oyvinmt/Automating-microscope-stages/README.md

# Automating-microscope-stages

Project for automatic Thorlabs microscope stages.

Contains stl files for 3d-prints, Arduino software, Python script and instructions for assembly and operation.
