oyvinmt/Automating-microscope-stages/Models/z_main_gear.stl

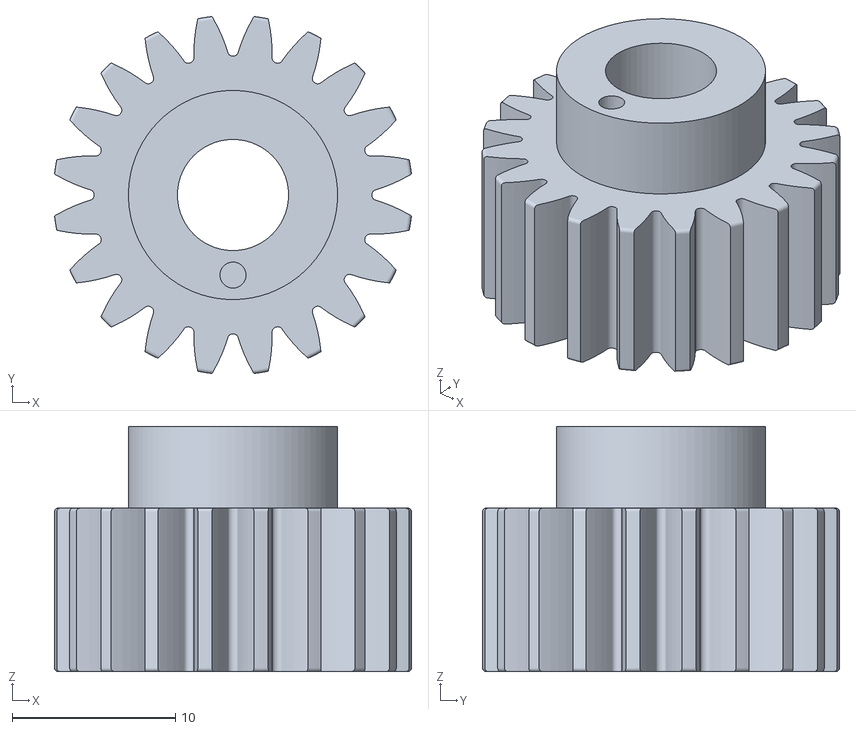
[picture p1: CAD file, 2021-06-25]
Models/z_main_gear.stl
21.8 x 21.8 x 15.0
