oyvinmt/Automating-microscope-stages/Models/z_second_gear.stl

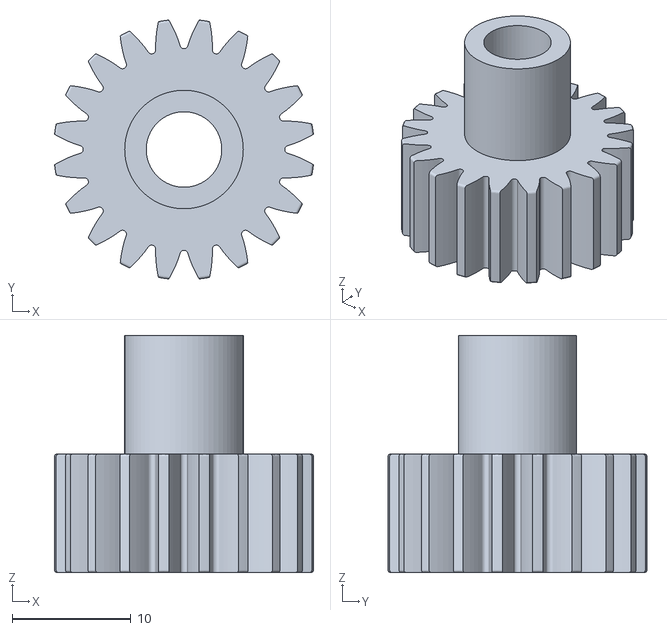
[picture p2: CAD file, 2021-06-25]
Models/z_second_gear.stl
21.8 x 21.8 x 20.0
