oyvinmt/Automating-microscope-stages/Models/Enclosure_body.stl

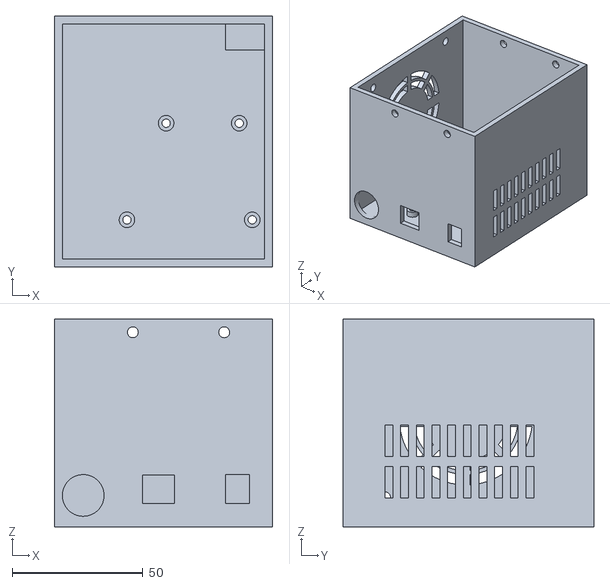
[picture p3: CAD file, 2021-06-25]
Models/Enclosure_body.stl
83.5 x 96.0 x 79.5
