oyvinmt/Automating-microscope-stages/Models/y_bracket.stl

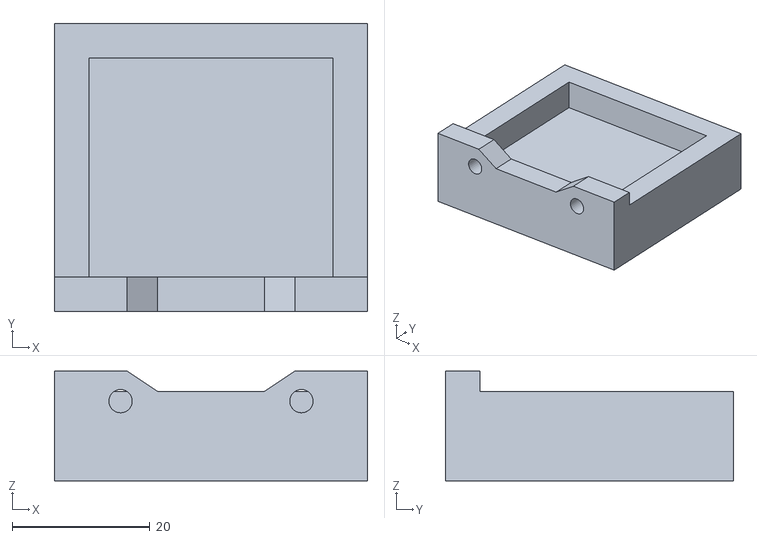
[picture p4: CAD file, 2021-06-25]
Models/y_bracket.stl
45.5 x 41.9 x 16.0
