oyvinmt/Automating-microscope-stages/Models/z_bracket.stl

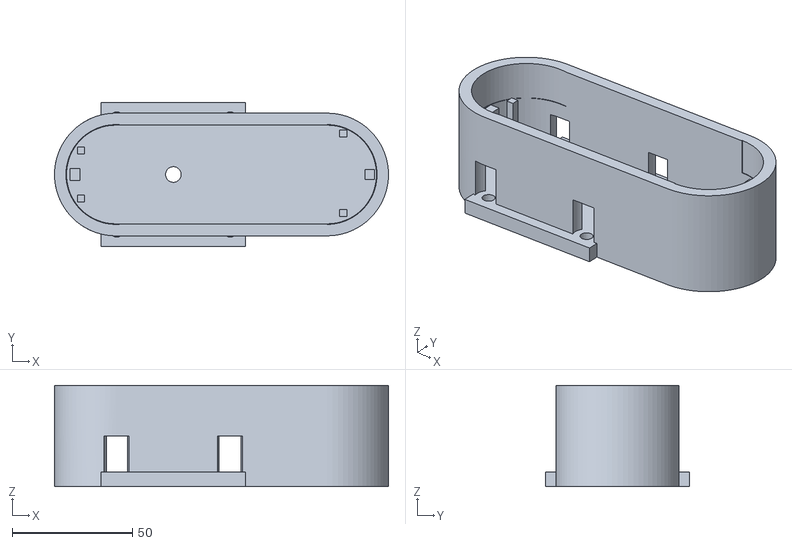
[picture p5: CAD file, 2021-06-25]
Models/z_bracket.stl
138.8 x 60.0 x 42.0
