oyvinmt/Automating-microscope-stages/Models/x_gear_1.stl

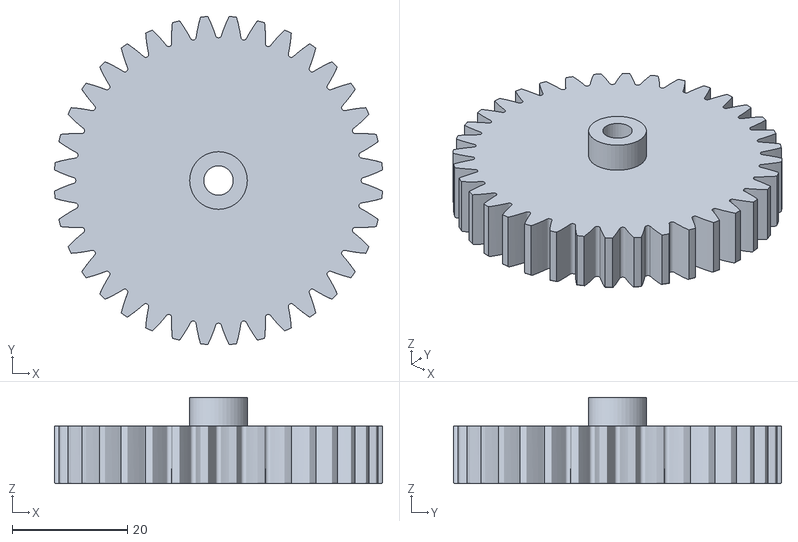
[picture p6: CAD file, 2021-06-25]
Models/x_gear_1.stl
56.9 x 56.9 x 15.0
