oyvinmt/Automating-microscope-stages/Models/y_coupling.stl

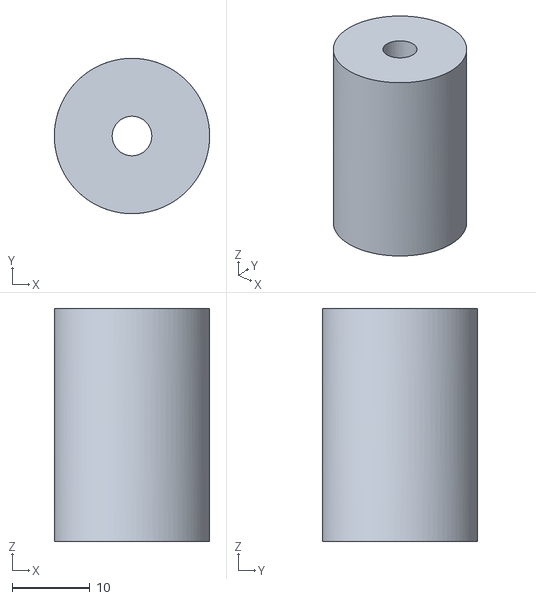
[picture p7: CAD file, 2021-06-25]
Models/y_coupling.stl
20.0 x 20.0 x 30.0
