oyvinmt/Automating-microscope-stages/Models/y_rail.stl

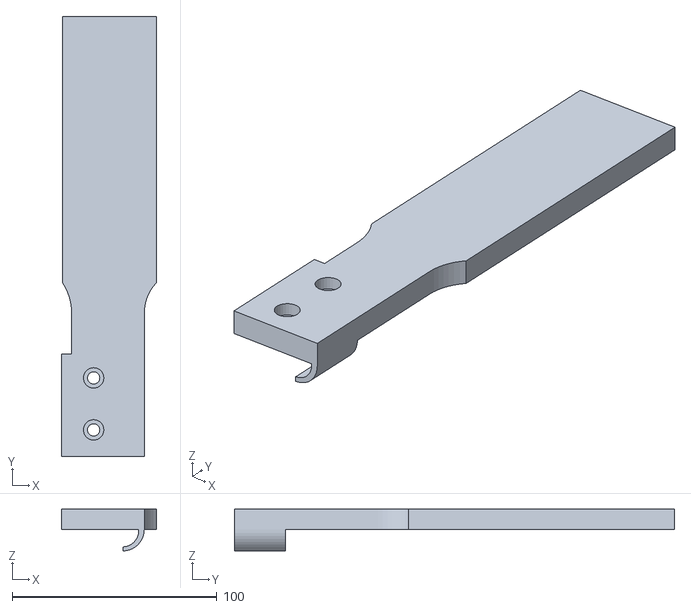
[picture p8: CAD file, 2021-06-25]
Models/y_rail.stl
46.5 x 215.0 x 20.5
