oyvinmt/Automating-microscope-stages/Models/x_gear_2.stl

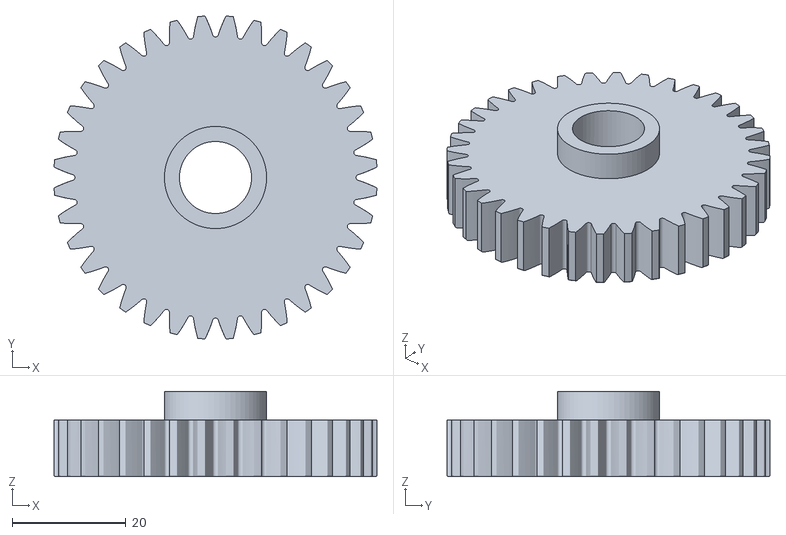
[picture p9: CAD file, 2021-06-25]
Models/x_gear_2.stl
56.9 x 56.9 x 15.0
