oyvinmt/Automating-microscope-stages/Models/x_motor_mount.stl

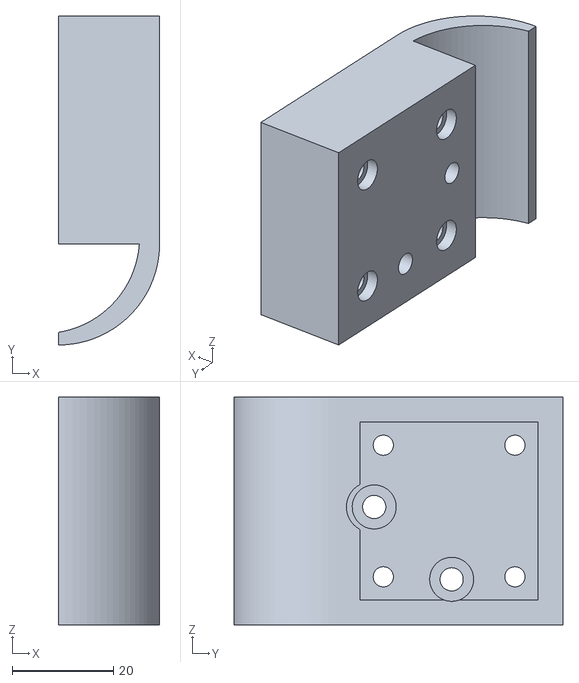
[picture p10: CAD file, 2021-06-25]
Models/x_motor_mount.stl
20.0 x 65.0 x 45.0
