oyvinmt/Automating-microscope-stages/Models/Enclosure_Lid.stl

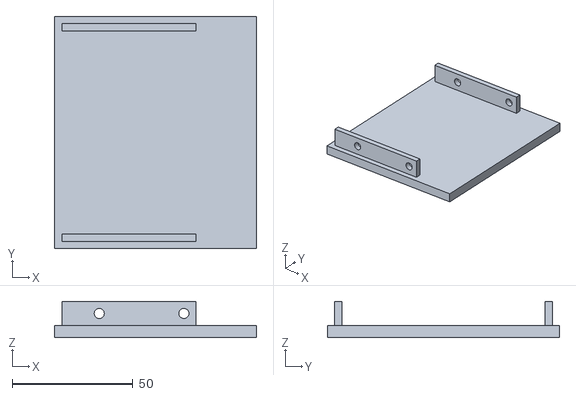
[picture p11: CAD file, 2021-06-25]
Models/Enclosure_Lid.stl
83.5 x 96.0 x 15.0
