oyvinmt/Automating-microscope-stages/Manual.pdf

# Operation manual

Øyvind M. Taraldsen

June 2021

## 1 Warnings

Do not power on the device without the motors attached as shown in figure 1. The Arduino can be powered on without issues, the dedicated motor supply can not.

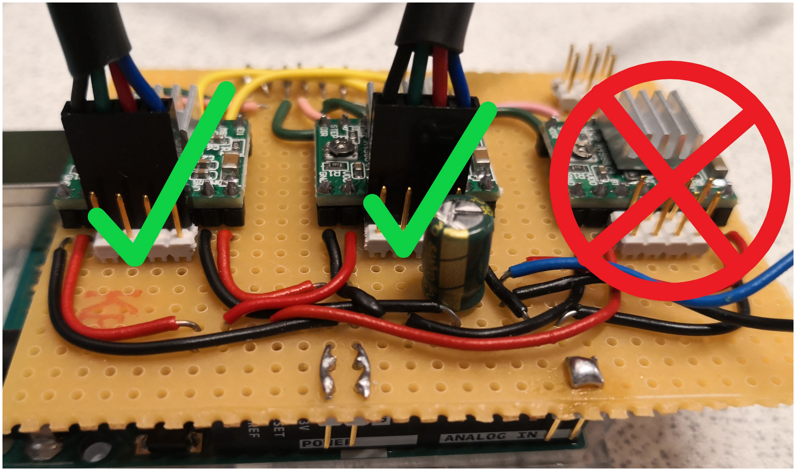
[picture p12: figure]

Figure 1: Never power on the device with nothing connected to the controller outputs. Doing so will burn out the controllers instantly.

## 2 Basic operation

Plug in the Arduino, the separate power supply for the motors and start the Python-script. The script should automatically detect the Arduino and connect to it 1
. You should see ”Arduino is ready” and a pygame window appearing when it is working correctly.

1Note that any programs running that connect through a serial interface to an Arduino (like the Arduino IDE) may autoconnect and block the script from doing so.

Operation is done through the Python-script in https://github.com/oyvinmt/Automating-microscopestages that sends information from keyboard inputs through a serial interface to the Arduino 2
. Note that
the pygame window must be in focus for it to detect keyboard inputs.
Keybindings
Function | Keys
x-y movement z movement Step size Steps per second Exit | keypad arrows keypad ug up and pg dn keypad insert, end and home + and -Esc

As the stepper motors are powered at full current when not moving it is probably good to unplug the device when not in use.

## 3 Connections and adjustments

This section contains information that may be necessary for repairs and reassembly.
For connecting the controller board to the Arduino, figures 2 and 3 shows the correct pin plugin. The connections to the fan and switch is shown in figure 5.
See figure 4 for current adjustments. See the datasheet of the A4988 controller for further details.

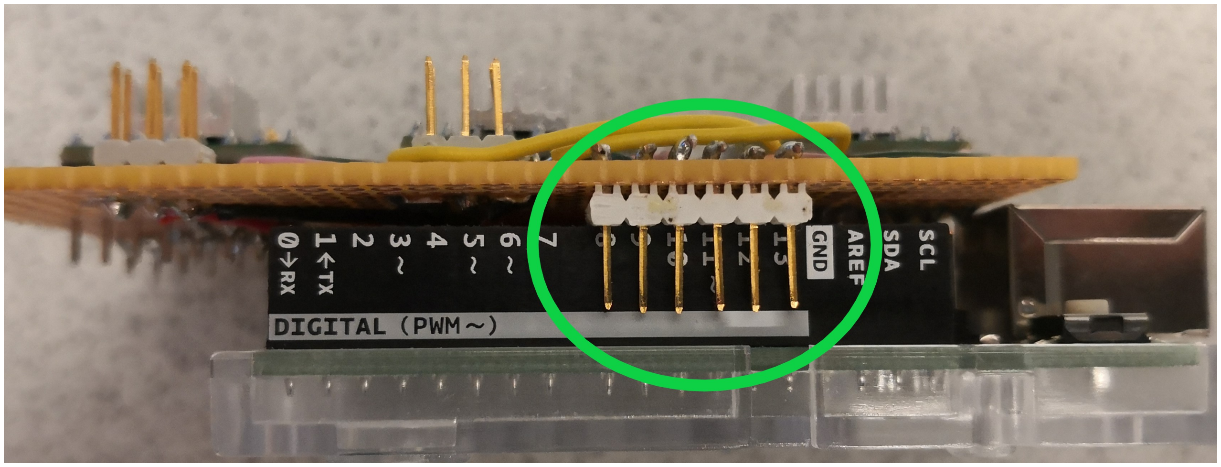
[picture p13: figure]

Figure 2: Highlight of the correct pins for mounting the controller card on the Arduino.

2Keybindings can be changed by modifying the script.

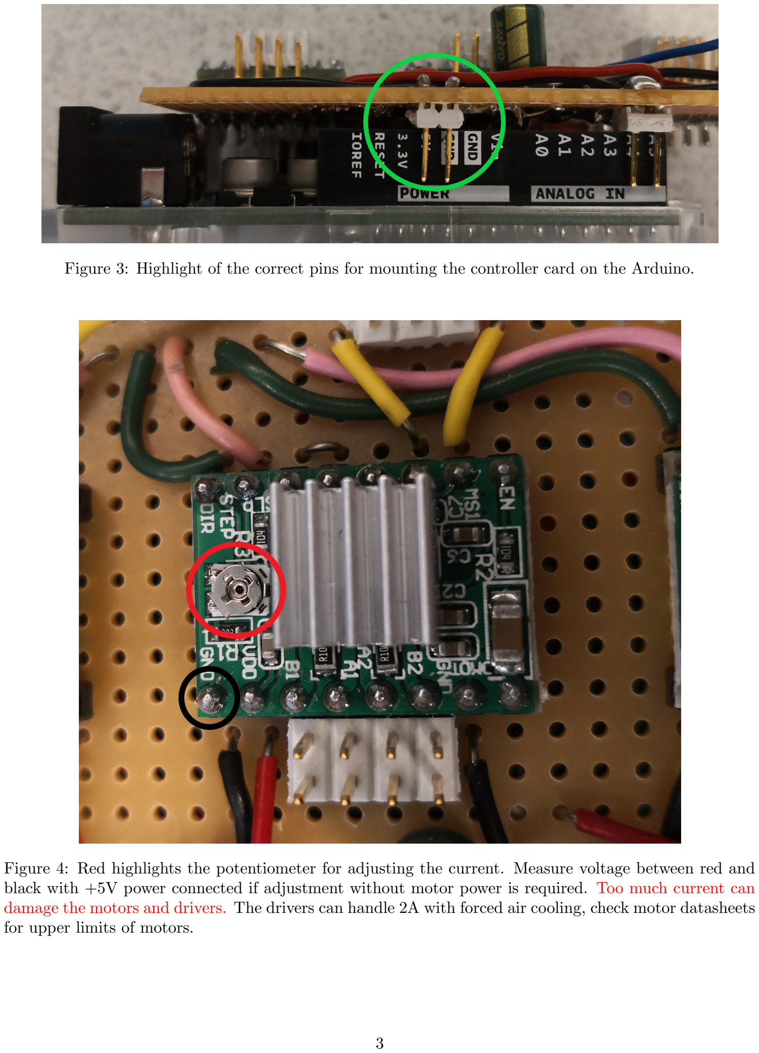
[picture p14: page 3]

Figure 3: Highlight of the correct pins for mounting the controller card on the Arduino.

Figure 4: Red highlights the potentiometer for adjusting the current. Measure voltage between red and black with +5V power connected if adjustment without motor power is required. Too much current can damage the motors and drivers. The drivers can handle 2A with forced air cooling, check motor datasheets for upper limits of motors.

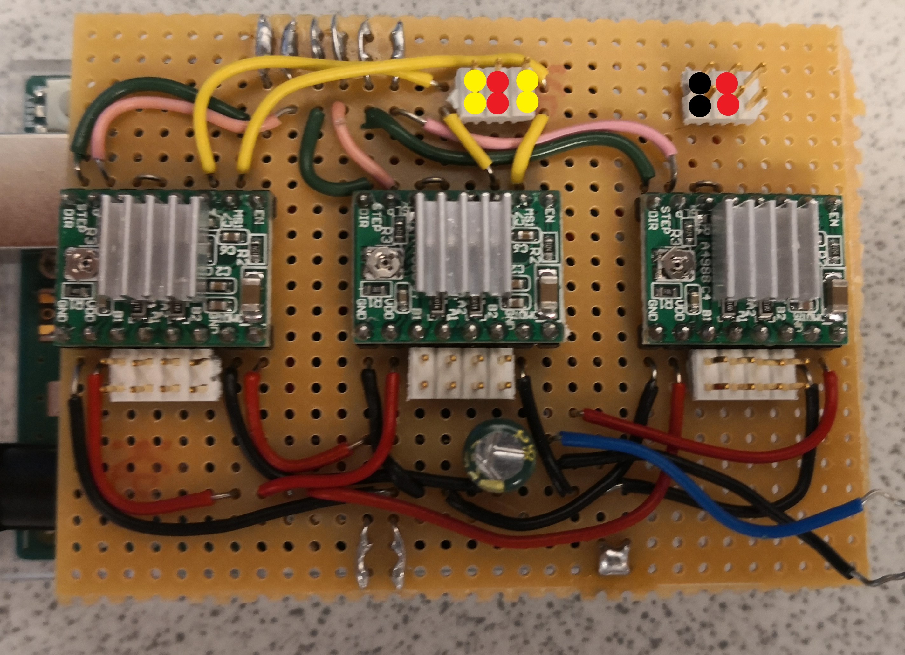
[picture p15: figure]

Figure 5: Pin outs for the fan (top right) and step-size switch (top middle). Red indicates +5V, black indicates logic ground, yellow indicates controller pins.

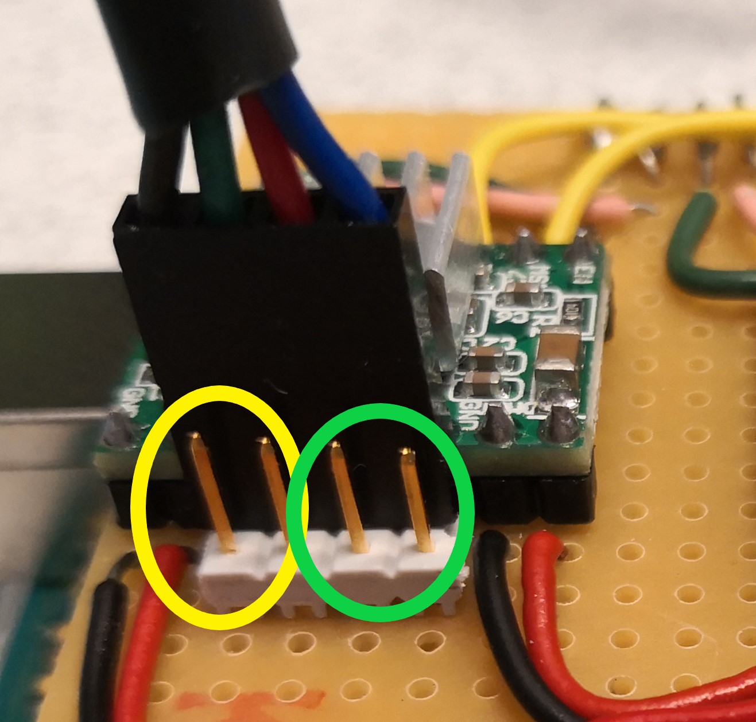
[picture p16: figure]

Figure 6: Stepper motor coils are connected pairwise to the boards as indicated, the first coil to yellow, the second to green. See datasheets for the motors and drivers for details.

## 4 Parts list

- 2x NEMA 14 1A stepper motors
- 1x NEMA 23 2A stepper motor
- 1x Arduino UNO
- 3x A4988 or equivalent controller boards
- 1x 100µF 25V capacitor
- 1x 13.5V 1A power supply
- Wire, solder etc.

Note that the power supply may be exchanged for any unit delivering up to 30V DC, the capacitor must then be changed accordingly. Significantly lower voltage supplies will still work, but are not recommended as the motors will have very low torque.
