oyvinmt/Automating-microscope-stages/(commit log)

2021-06-24 Add files via upload
    Arduino sketch for stepper control
2021-06-25 added 3d printing models
    [Enclosure_Lid.stl, Enclosure_body.stl, x_gear_1.stl, x_gear_2.stl, x_motor_mount.stl, y_bracket.stl, y_coupling.stl, y_rail.stl]
2021-06-25 added model
    [z_second_gear.stl]
